viniciuscacarvalho/9S/README.md

9S = Sensoring System for Surface Sea Streams and Scan of Sustainable Energy Streams
