viniciuscacarvalho/9S/report/images/chapter/analysis/sonda_edited.jpg

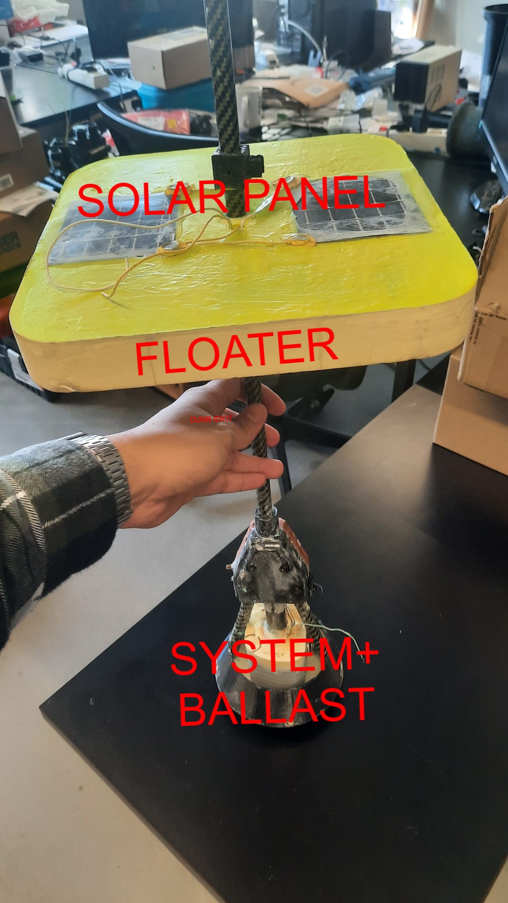
report/images/chapter/analysis/sonda_edited.jpg
