viniciuscacarvalho/9S/report/images/chapter/design/IMU.jpeg

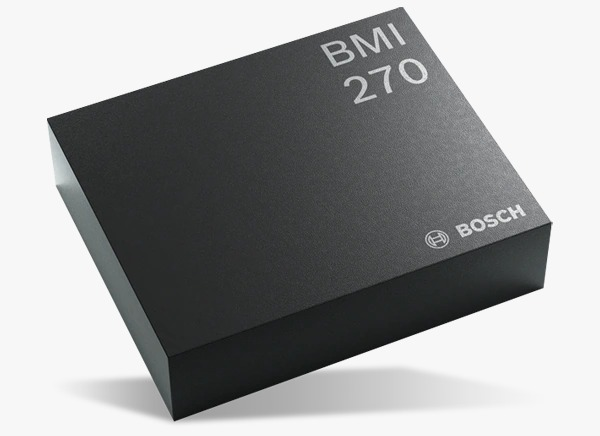
report/images/chapter/design/IMU.jpeg
