viniciuscacarvalho/9S/report/images/chapter/design/SIM7600_board.png

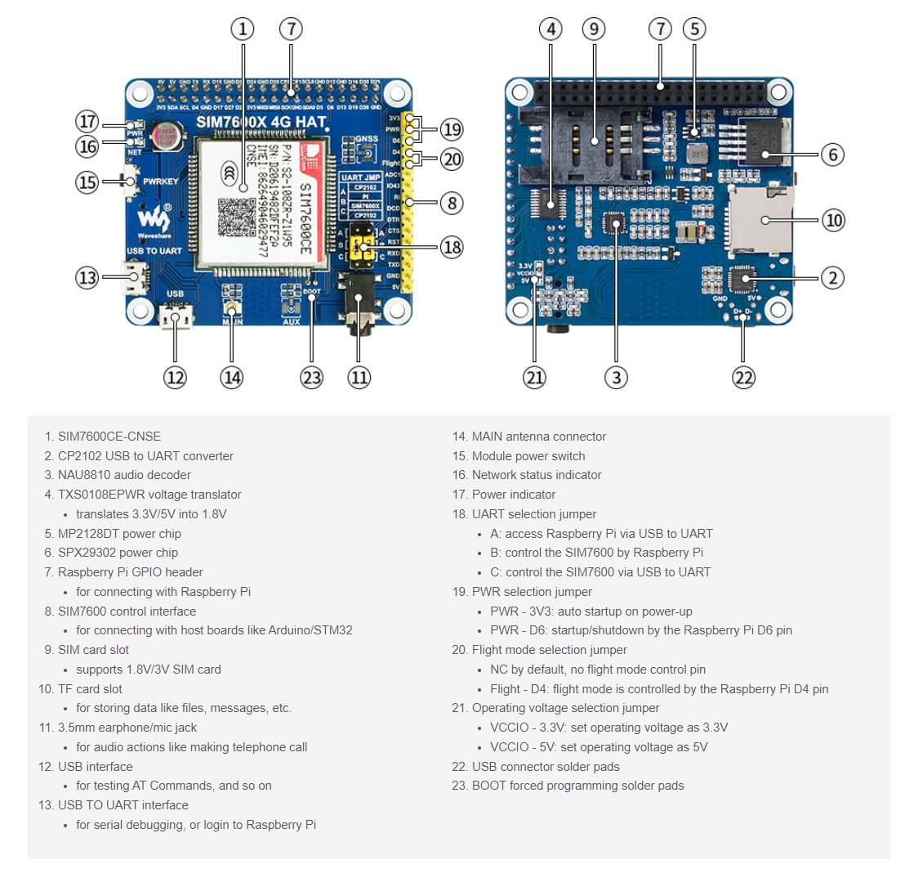
report/images/chapter/design/SIM7600_board.png
