viniciuscacarvalho/9S/report/images/chapter/implementation/Cesto.png

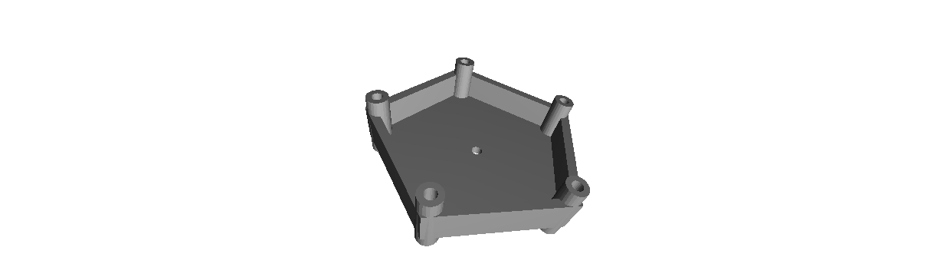
report/images/chapter/implementation/Cesto.png
