viniciuscacarvalho/9S/report/images/chapter/implementation/ponta.png

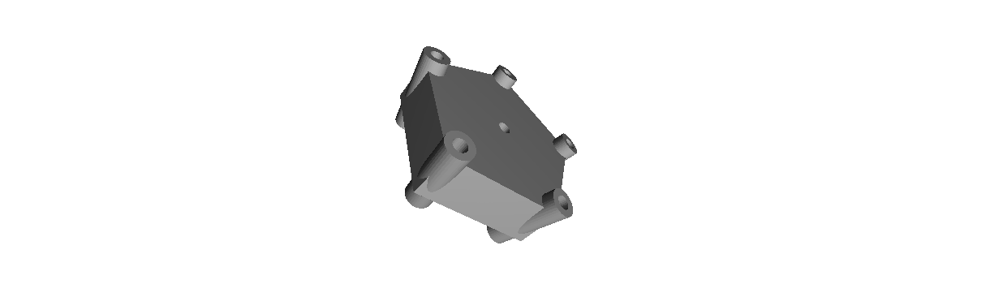
report/images/chapter/implementation/ponta.png
