viniciuscacarvalho/9S/report/images/chapter/implementation/Virtual timer.png

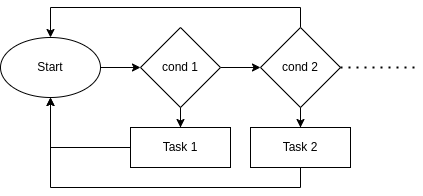
report/images/chapter/implementation/Virtual timer.png
