viniciuscacarvalho/9S/report/images/diagrams/block_diagram/block_diagram_1/block_diagram.drawio.png

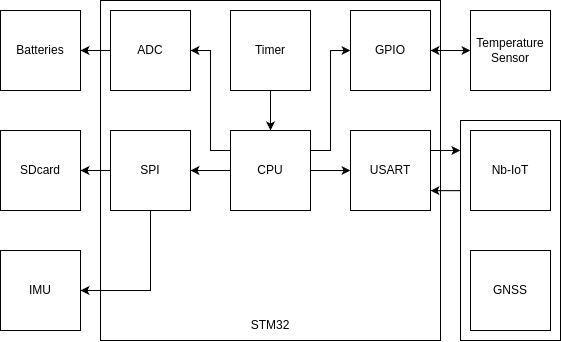
report/images/diagrams/block_diagram/block_diagram_1/block_diagram.drawio.png
