viniciuscacarvalho/9S/report/images/diagrams/block_diagram/block_diagram_2/block_diagram.png

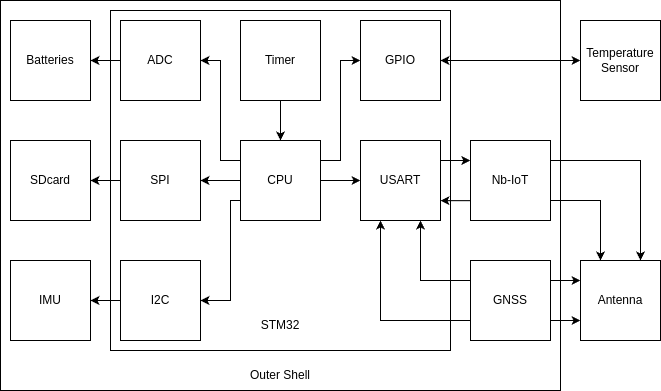
report/images/diagrams/block_diagram/block_diagram_2/block_diagram.png
