viniciuscacarvalho/9S/report/images/diagrams/block_diagram/block_diagrams_3/vlockdiagram_design.drawio.png

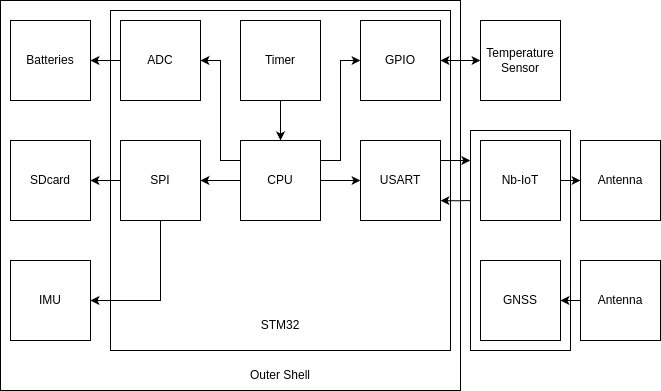
report/images/diagrams/block_diagram/block_diagrams_3/vlockdiagram_design.drawio.png
