viniciuscacarvalho/9S/report/images/diagrams/sequence_diagram/sequence_diagram_2/Sequence Diagram.drawio.png

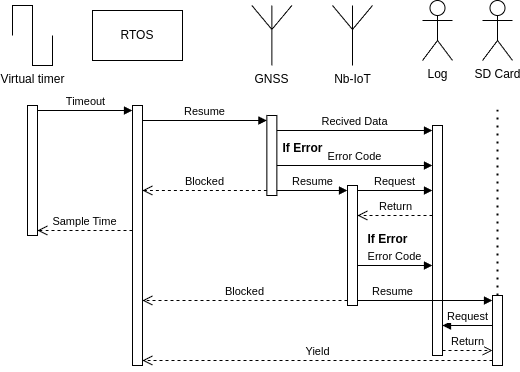
report/images/diagrams/sequence_diagram/sequence_diagram_2/Sequence Diagram.drawio.png
