viniciuscacarvalho/9S/report/images/diagrams/use_case/Use Case.drawio.png

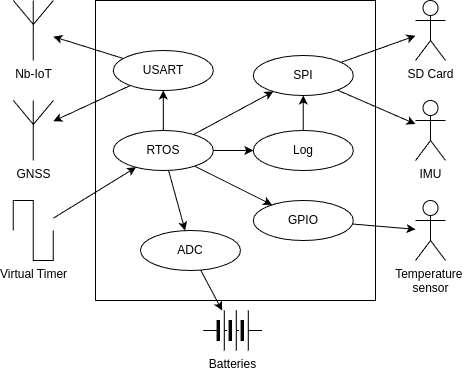
report/images/diagrams/use_case/Use Case.drawio.png
