viniciuscacarvalho/9S/report/images/diagrams/use_case/use_case_1/Use Case.drawio.png

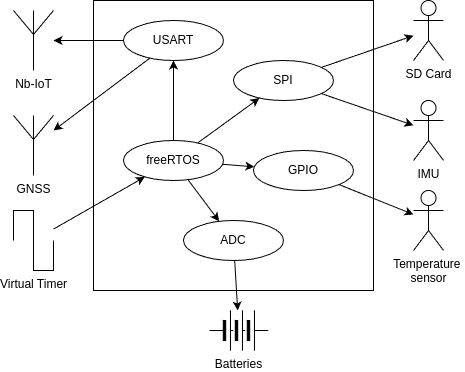
report/images/diagrams/use_case/use_case_1/Use Case.drawio.png
