viniciuscacarvalho/9S/report/images/diagrams/use_case/use_case_2/Use Case.drawio.png

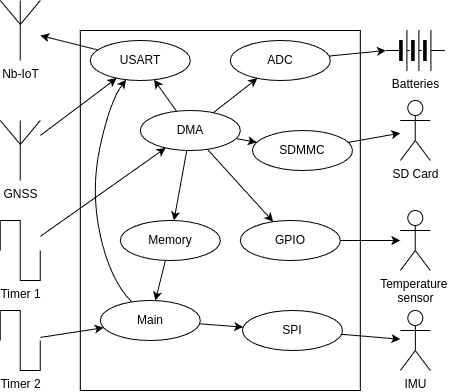
report/images/diagrams/use_case/use_case_2/Use Case.drawio.png
