viniciuscacarvalho/9S/kicad_project/footprints/LIB_SPV1050TTR/SPV1050TTR/3D/SPV1050TTR.stp

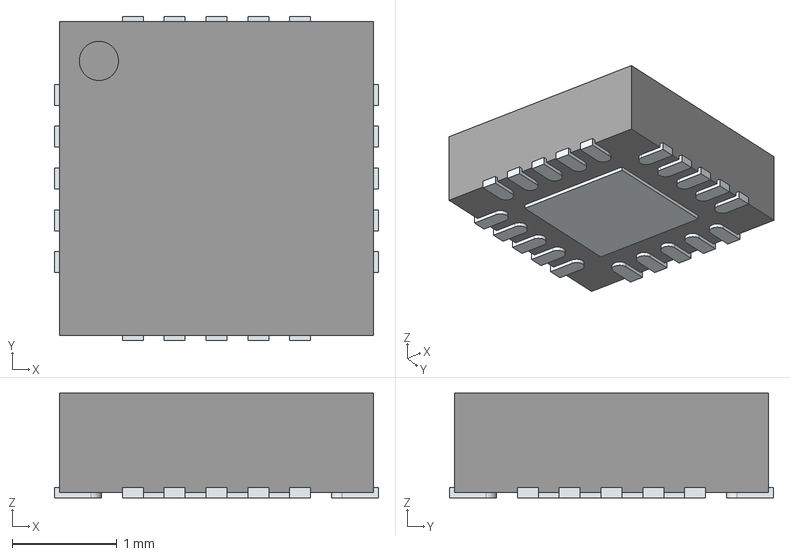
[picture p42: CAD file, 2025-11-12]
kicad_project/footprints/LIB_SPV1050TTR/SPV1050TTR/3D/SPV1050TTR.stp
3.10 x 3.10 x 1.00 mm
ThermalPin
PinsArrayLR
PinsArrayTB
