viniciuscacarvalho/9S/kicad_project/footprints/LIB_AEM10941-QFN/AEM10941-QFN/3D/AEM10941-QFN.stp

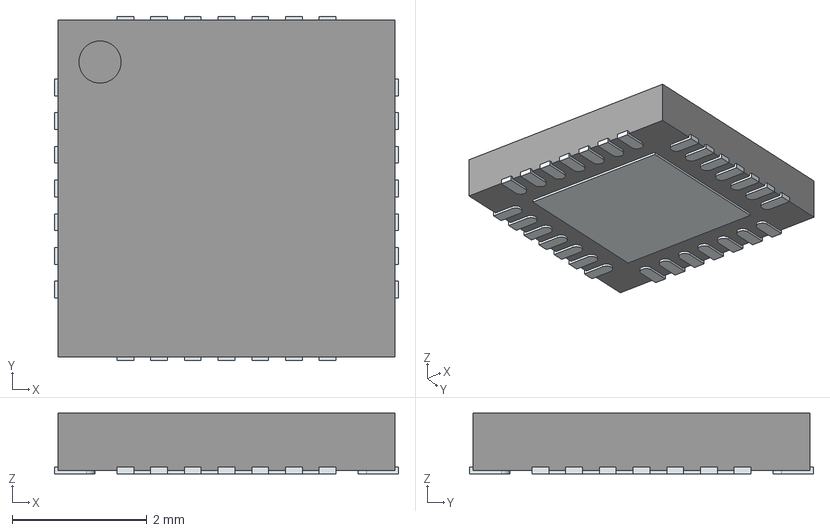
[picture p43: CAD file, 2025-10-08]
kicad_project/footprints/LIB_AEM10941-QFN/AEM10941-QFN/3D/AEM10941-QFN.stp
5.10 x 5.10 x 0.9 mm
ThermalPin
PinsArrayLR
PinsArrayTB
