viniciuscacarvalho/9S/(list of files, cad)

Other CAD files:
kicad_project/footprints/LIB_AEM10941-QFN/AEM10941-QFN/Allegro/qfn50p500x500x90-29n-d.psm
kicad_project/footprints/LIB_AEM10941-QFN/AEM10941-QFN/DEHDL/aem10941_qfn/chips/chips.prt
kicad_project/footprints/LIB_SPV1050TTR/SPV1050TTR/Allegro/qfn40p300x300x100-21n-d.psm
kicad_project/footprints/LIB_SPV1050TTR/SPV1050TTR/DEHDL/spv1050ttr/chips/chips.prt
