viniciuscacarvalho/9S/(list of files, drawings)

Other design files:
kicad_project/footprints/LIB_AEM10941-QFN/AEM10941-QFN/Altium/AEM10941-QFN.SchLib
kicad_project/footprints/LIB_AEM10941-QFN/AEM10941-QFN/Altium/QFN50P500X500X90-29N-D.PcbLib
kicad_project/footprints/LIB_SPV1050TTR/SPV1050TTR/Altium/QFN40P300X300X100-21N-D.PcbLib
kicad_project/footprints/LIB_SPV1050TTR/SPV1050TTR/Altium/SPV1050TTR.SchLib
