viniciuscacarvalho/9S/stm32_code/9s.ioc

Mcu.UserName=STM32H755ZITx
PA0.Signal=ADC1_INP16
PA1.Signal=ETH_REF_CLK
PA11.Signal=USB_OTG_FS_DM
PA12.Signal=USB_OTG_FS_DP
PA2.Signal=ETH_MDIO
PA7.Signal=ETH_CRS_DV
PA8.Signal=USB_OTG_FS_SOF
PA9.Signal=USB_OTG_FS_VBUS
PB0.Signal=GPIO_Output
PB13.Signal=ETH_TXD1
PB14.Signal=GPIO_Output
PB15.Signal=USART1_RX
PB6.Signal=USART1_TX
PB8.Signal=I2C1_SCL
PB9.Signal=I2C1_SDA
PC1.Signal=ETH_MDC
PC12.Signal=SDMMC1_CK
PC13.Signal=GPIO_Input
PC4.Signal=ETH_RXD0
PC5.Signal=ETH_RXD1
PC8.Signal=SDMMC1_D0
PD10.GPIO_Label=USB_OTG_FS_PWR_EN
PD10.Signal=GPIO_Output
PD2.Signal=SDMMC1_CMD
PD8.Signal=USART3_TX
PD9.Signal=USART3_RX
PE1.Signal=GPIO_Output
PG11.Signal=ETH_TX_EN
PG13.Signal=ETH_TXD0
PG7.GPIO_Label=USB_OTG_FS_OVCR
PG7.Signal=GPXTI7
