viniciuscacarvalho/9S/stm32_code/CM7/manager/managers_behavior/battery_behavior.h

/*
 * battery_behavior.h
 *
 *  Created on: Jun 2, 2025
 *      Author: viny
 */

#ifndef MANAGER_MANAGERS_BEHAVIOR_BATTERY_BEHAVIOR_H_
#define MANAGER_MANAGERS_BEHAVIOR_BATTERY_BEHAVIOR_H_

#include "../manager.h"

void battery_init (void);
void battery_update (void);

#endif /* MANAGER_MANAGERS_BEHAVIOR_BATTERY_BEHAVIOR_H_ */
