viniciuscacarvalho/9S/stm32_code/CM7/manager/managers_behavior/imu_behavior.h

/*
 * imu_behavior.h
 *
 *  Created on: Jun 2, 2025
 *      Author: viny
 */

#ifndef MANAGER_MANAGERS_BEHAVIOR_IMU_BEHAVIOR_H_
#define MANAGER_MANAGERS_BEHAVIOR_IMU_BEHAVIOR_H_

#include "../manager.h"

void imu_init (void);
void imu_update (void);



#endif /* MANAGER_MANAGERS_BEHAVIOR_IMU_BEHAVIOR_H_ */
