viniciuscacarvalho/9S/stm32_code/CM7/manager/managers_behavior/temp_sensor/delay.c

#include "delay.h"

void Delay_us(uint32_t us) {
    uint32_t start = DWT->CYCCNT;
    us *= (SystemCoreClock / 1000000);
    while ((DWT->CYCCNT - start) < us);
}

void DWT_Init(void) {
    CoreDebug->DEMCR |= CoreDebug_DEMCR_TRCENA_Msk;
    DWT->CTRL |= DWT_CTRL_CYCCNTENA_Msk;
}
