viniciuscacarvalho/9S/stm32_code/CM7/manager/with_RTOS/task_behavior/cnss_task.c

/*
 * cnss_task.c
 *
 *  Created on: Apr 23, 2025
 *      Author: viny
 */

#include "cnss_task.h"

void cnss_task(void *argument)
{
	//setup
	//HAL_UART_Transmit_IT(&huart3, "Gnss\n", 5);
	//loop
	while(1)
	{
		osDelay(DELAY_MAX);
	}

}
