viniciuscacarvalho/9S/stm32_code/CM7/manager/with_RTOS/task_behavior/nb_iot_task.h

/*
 * nb_iot_task.h
 *
 *  Created on: Apr 23, 2025
 *      Author: viny
 */

#ifndef PROJECT_TASK_BEHAVIOR_NB_IOT_TASK_H_
#define PROJECT_TASK_BEHAVIOR_NB_IOT_TASK_H_

#include "../task_header.h"

void nb_iot_task(void *argument);

#endif /* PROJECT_TASK_BEHAVIOR_NB_IOT_TASK_H_ */
