viniciuscacarvalho/9S/stm32_code/CM7/manager/with_RTOS/task_behavior/sd_card_task.c

/*
 * sd_card_task.c
 *
 *  Created on: Apr 23, 2025
 *      Author: viny
 */
#include "sd_card_task.h"

// File system object
FATFS fs;
// File object
FIL fil;
// Result code
FRESULT res;
// File write count
UINT bw;

void sd_card_task(void *argument)
{
	//setup
	char to_store[255] = {"Test without format"};
	write_to_sd_card(to_store);
	//HAL_UART_Transmit_IT(&huart3, "SD-Card\n", 8);
	//loop


	while(1)
	{
		osDelay(DELAY_MAX);
	}

}

void write_to_sd_card(char *to_send)
{

}
