viniciuscacarvalho/9S/stm32_code/CM7/manager/with_RTOS/task_behavior/sd_card_task.h

/*
 * sd_card_task.h
 *
 *  Created on: Apr 23, 2025
 *      Author: viny
 */

#ifndef PROJECT_TASK_BEHAVIOR_SD_CARD_TASK_H_
#define PROJECT_TASK_BEHAVIOR_SD_CARD_TASK_H_

#include "../task_header.h"

void sd_card_task(void *argument);


#endif /* PROJECT_TASK_BEHAVIOR_SD_CARD_TASK_H_ */
