viniciuscacarvalho/9S/stm32_code/CM7/manager/with_RTOS/task_behavior/temp_task.h

/*
 * temp_task.h
 *
 *  Created on: Apr 23, 2025
 *      Author: viny
 */

#ifndef PROJECT_TASK_BEHAVIOR_TEMP_TASK_H_
#define PROJECT_TASK_BEHAVIOR_TEMP_TASK_H_

#include "../task_header.h"
#include "../../one_wire/ds18b20.h"



void temp_task(void *argument);


#endif /* PROJECT_TASK_BEHAVIOR_TEMP_TASK_H_ */
