viniciuscacarvalho/9S/(notices)

Notices in the files:
stm32_code/CM7/Core/Src/main.c:
Copyright (c) 2025 STMicroelectronics.
All rights reserved.
This software is licensed under terms that can be found in the LICENSE file
